ivy987654/esp32/PROTOCOL.md

# 串口协议（Mac → 板子）

UART0，460800 8N1（板子开机后从 115200 切到 460800；Mac 上的 CH340 跑不了 921600）。

## 帧

```
A5 5A | type(1) | len(2, LE) | payload[len] | crc16(2, LE)
```

- crc16 = CRC-16/CCITT-FALSE（poly 0x1021，init 0xFFFF），算 type+len+payload。
- payload 最长 1100 字节。CRC 不对整帧丢弃，所以字段永远不会串位。
- 文本帧：UTF-8 字段，用 0x1F 分隔。

| type | 字段 |
|---|---|
| M | 歌名, 歌手, 专辑, 播放中(0/1), 进度ms, 总长ms |
| Y | 歌词 前2, 前1, 当前, 后1, 后2 |
| C | unix 秒, 时区偏移秒 |
| W | 城市, 温度, 天气, 今日范围, 体感, 湿度, 风, 预报1, 预报2, 预报3 |
| R | 状态(idle/listen/think/speak), 情绪(happy/sad/angry/surprised/calm/playful), 用户说的, 小耄说的 |
| V | 麦克风音量 0-100（约 10Hz） |
| K | 刚按的键, 键值, 最近输入, 今日次数, 每分钟按键数 |
| S | CPU%, GPU%, 内存%, 内存用量, 下行, 上行, Codex 本周剩余%, Codex 5 小时, Claude 本周剩余%, Claude 5 小时 |
| H | 封面 id, 整图 crc32 |
| A | 二进制：id(u32) + 偏移(u32) + 最多 1024 字节像素 |

封面：240×240 RGB565 小端，分块发送。板子收齐所有块并且整图 crc32 对上才替换显示。

电脑端每 3 秒把所有状态帧重发一遍，所以偶尔丢一帧只会晚一点刷新。

## 板子 → 电脑

每秒一行文本：`#S up=<秒> ok=<好帧> bad=<坏帧> art=<当前封面id> hi=<内部RAM空闲> hp=<PSRAM空闲>`

电脑端据此判断板子是否重启（up 变小 → 全部重发）和封面是否到位（art 不等 → 5 秒后重发）。
