ivy987654/esp32/UPLOAD_REVIEW.md

# 源码上传审查记录

审查日期：2026-10-28。范围：提供的 maodie_dashboard_src.zip，共 18 个文件；以及已上传的根目录 README.md。目标为个人私有仓库。

## 密钥和个人配置

- 源码中的 LLM_API_KEY 从运行用户的 ~/.maodie.env 读取，示例文件中的值为空；此次扫描实际密钥命中数为 0。
- 原始包的文件清单中实际环境配置、日志、聊天记录、录音、模型缓存、证书和私钥文件数量均为 0。
- launchd 配置中的本机用户名与绝对路径已替换为 YOUR_USERNAME 模板；使用前填写本机路径。
- 固定串口编号已替换为占位符；PlatformIO 串口设置改为注释，按需填写。
- 麦克风设备名称已清空，使用系统默认设备。
- README 中的个人 Claude Artifact 链接已移除。此前 README 提交仍保留该链接和用户名的历史记录。
- .gitignore 排除环境配置、私钥、字体、压缩包、构建输出、模型、缓存和日志。

## 字体与源码

- dashboard/main/font.ttf 为原包内唯一二进制资源，按提供者说明来自 macOS 冬青黑体裁剪，已从上传文件中排除。原始压缩包也保留在本机。
- CMake 与 platformio.ini 继续使用 main/font.ttf。克隆后先在本机补齐字体，再执行 pio run -t upload。字体生成工具保留。
- 界面、触摸、串口、电脑端脚本及配置以源码形式保存。
- dashboard/main/board.c 顶部标注引脚与时序参考 ALIENTEK 的 23_rgb / 24_touch 例程，原注释已保留。公开发布前需核实所采用代码的授权范围。
- 参考资料：[正点原子官方开发板仓库](https://github.com/openedv/ATK-DNESP32S3-Board)。其公开目录列有相关例程；本次审查检索到的许可证位于其他特定组件目录，板级例程授权仍为待核实项。
- 项目自身开源许可证待作者选定；此次按私有备份保存。

## 外部依赖与服务

- LVGL 与 ESP-IDF 等由构建工具下载，仓库保存依赖声明。
- Python 依赖由 uv 下载；语音模型由脚本运行时下载到用户缓存。此次上传文件仅包含调用代码。
- 网易云、LRCLIB、wttr.in 与大模型 API 以网络接口调用，音乐封面、歌词正文、语音模型及 macOS say 资源均由运行环境获取。

## 验证

完成全包文件清单检查、文本逐项检查、常见密钥格式与私钥标记扫描、配置赋值检查、Python 语法解析和 plist 解析。固件编译与硬件运行验证留在本机补齐字体后执行。
