ivy987654/esp32/docs/maodie-dashboard.jpg

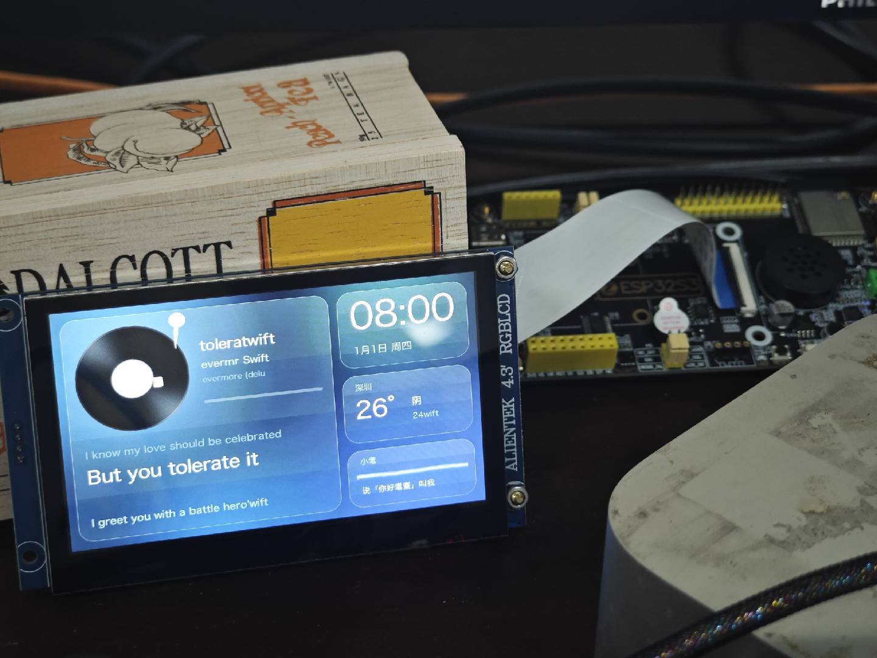
docs/maodie-dashboard.jpg
