ivy987654/esp32/case/out/back.stl

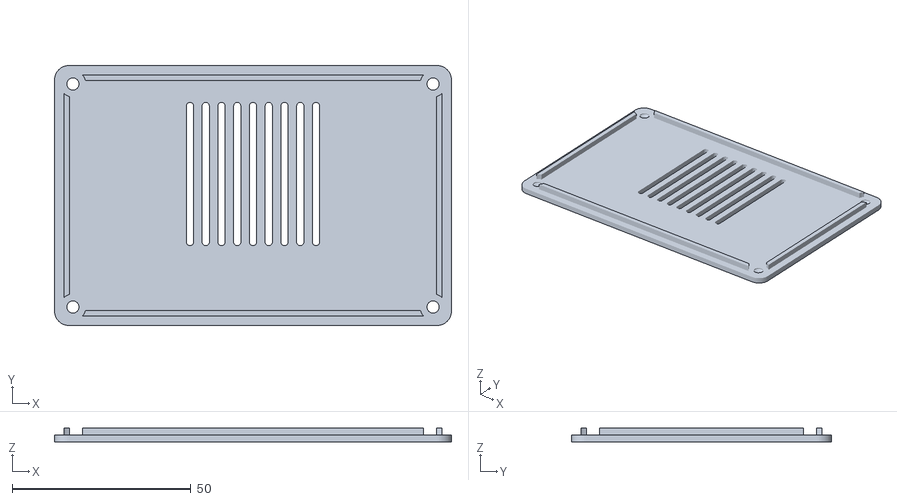
[picture p4: CAD file, 2026-10-30]
case/out/back.stl
110.9 x 72.6 x 4.00
