ivy987654/esp32/case/out/front.stl

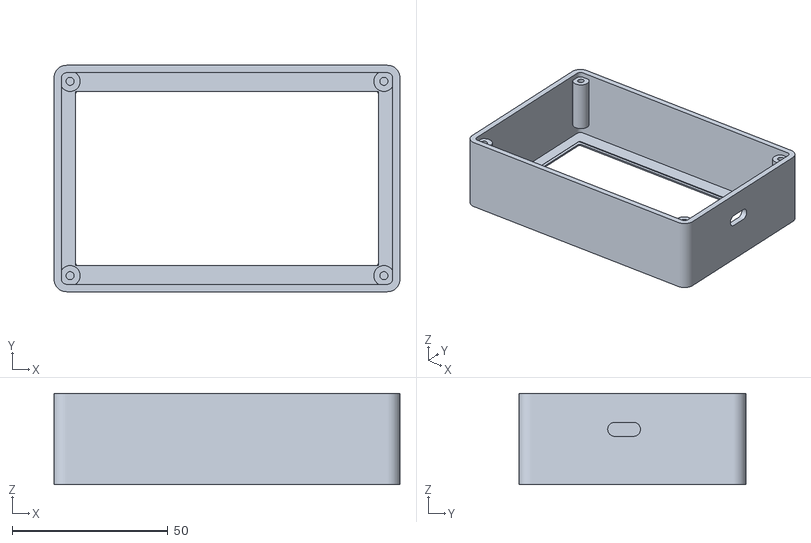
[picture p5: CAD file, 2026-10-30]
case/out/front.stl
110.9 x 72.6 x 29.3
