ivy987654/esp32/case/out/stand.stl

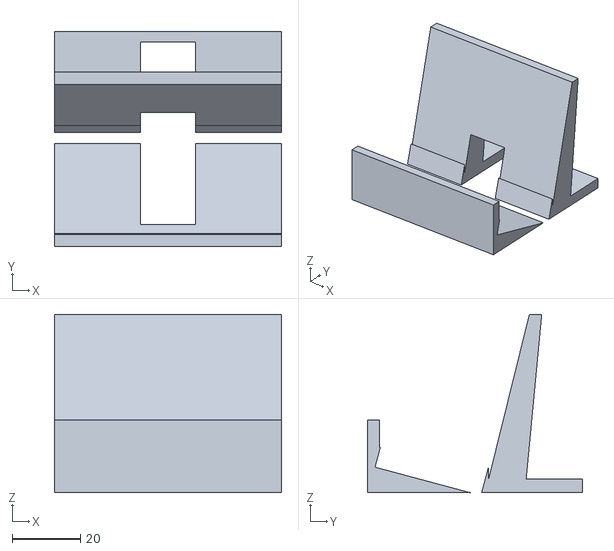
[picture p6: CAD file, 2026-10-30]
case/out/stand.stl
66.5 x 63.0 x 52.3
