ivy987654/esp32/(commit log)

2026-10-28 Add ESP32 desktop dashboard README
2026-10-28 小耄：桌面黑胶与猫猫助手
2026-10-28 完善 README 视觉排版与作者介绍
2026-10-28 完善项目标题、首页简介与展示文案
2026-10-28 添加小耄实物照片
2026-10-30 更新小耄 v0.2.0：三屏界面、系统额度监控与外壳模型
